navis-stella/weld-seam-laser-triangulation/evaluations/Summary_2026-10-31.xlsx

Sample | Images | SeamDetected | Height_Median | Height_P5 | Height_P95 | Width_Median | Width_P5 | Width_P95 | Images_with_Height | Images_with_Dip | Depth_Min | Offset_Median | Offset_Max | Contact_found | Length_mm | Length_Dev_Pct
Sample_2121_T30B30 | 720 | 569 | 0.7893599848 | 0.1627919175 | 1.031522102 | 2.722397041 | 1.237331751 | 3.399980044 | 544 | 5 | -0.5333279794 | 0.1199757125 | 0.37869876 | 720 | 57.76235559 | -0.4097317414
Sample_2133_T30B30 | 720 | 720 | 0.6347304916 | 0.2495801159 | 1.578254006 | 4.238905789 | 2.874864928 | 5.495652651 | 719 | 228 | -1.870344409 | 0.2122427572 | 0.7294869397 | 720 | 57.76256137 | -0.4093769547
Sample_2141_T30B30 | 720 | 718 | 0.6735791208 | 0.3330448282 | 0.9908154071 | 4.066497123 | 2.713002382 | 5.180682678 | 718 | 9 | -0.4754289943 | 0.1113570771 | 0.3783754926 | 720 | 57.87289732 | -0.2191425453
