navis-stella/weld-seam-laser-triangulation/evaluations/Sample_2121_T30B30/SeamWidth.jpg

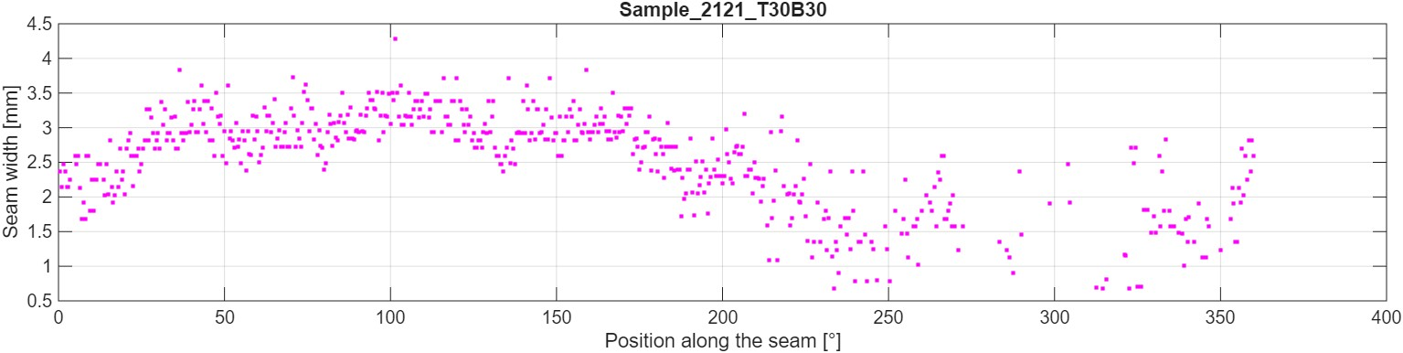
evaluations/Sample_2121_T30B30/SeamWidth.jpg
