navis-stella/weld-seam-laser-triangulation/evaluations/Sample_2133_T30B30/Seam3D_Unfolded.jpg

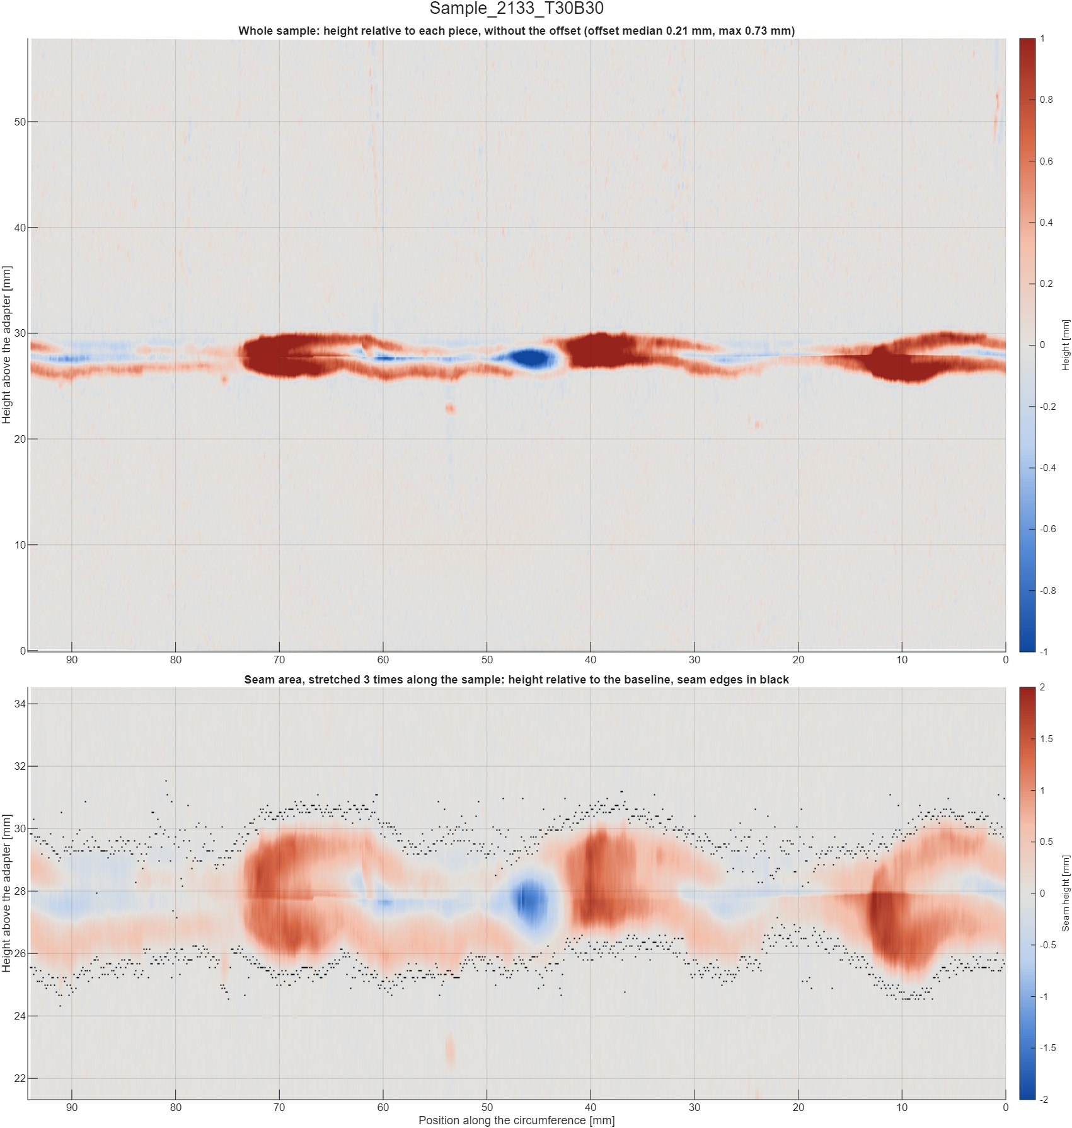
evaluations/Sample_2133_T30B30/Seam3D_Unfolded.jpg
