navis-stella/weld-seam-laser-triangulation/evaluations/Sample_2141_T30B30/SampleOffset.jpg

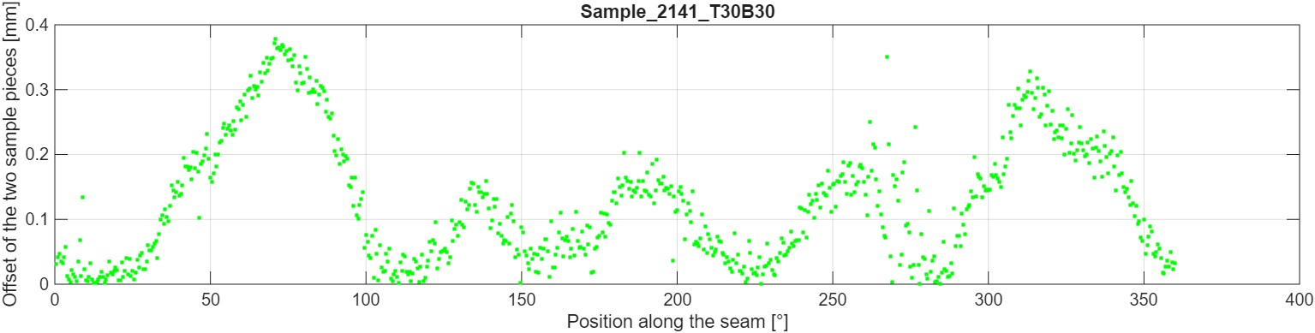
evaluations/Sample_2141_T30B30/SampleOffset.jpg
